Kulicheg/BomgeMoon/Images/BomgeMoon r1.jpg

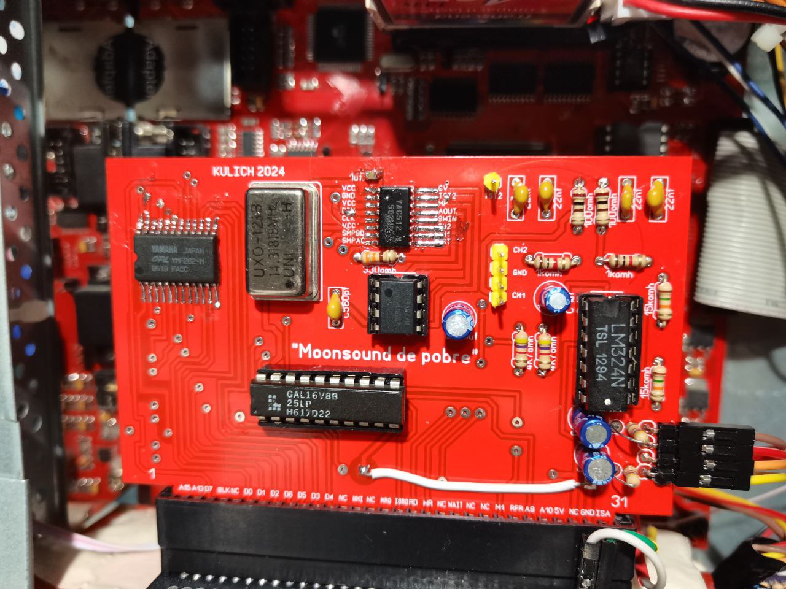
Images/BomgeMoon r1.jpg
