Kulicheg/BomgeMoon/README.md

# BomgeMoon
OPL3 sound card for ZX Spectrum

 Рекомендации:
 R8, R9 рекомендается  устанавливать меньшего номинала, вместо 15кОм следует устанавливать от 4.7 кОм. Для уменьшения искажений звука и уменьшения общей громкости карты.
 Резисторы на выходе карты  тогда можно заменить перемычками. Иначе для выравнивани громкости  можно установить резистор ~10 kOm

Revision 3  
- Edge коннектор сделан шире.  
- Увеличены отверстия под 3.5 джек.
- Исправлен шелк.

Внимание! Ревизия 01 содержит критические ошибки!
1) На лицевой стороне у Edge коннектора не убрана металицация и маска
2) У тестовых  площадок TST2 и CH2-GND-GND-CH1 нулевой отступ от полигонов что привело к КЗ между CH2-GND и TST2-GND (КЗ в переходном отверстии)
3) КЗ между 5в и 12в у разъема
4) КЗ между 5в и А11




**BOM**  
- DD1    YMF262-M    SOJ-24 
- DD2    GAL16V8     DIP-20
- DD3    YAC512      SOJ-16
- DD4    RC4558      DIP-8
- DD5    LM324       DIP-14 
- Q1     ген. 14,318 FULL
- C1     560pF  
- C2-C5  22nF  
- C6-C8  100 uF     5х7мм
- C9      1 uF      5х7мм
- C10-C14 1uF       0805  
- R1      330 Omh  
- R2, R3  4,7 kOmh  
- R4, R5  100 Omh  
- R6, R7  1 kOmph  
- R8, R9  15 kOmph
