Kulicheg/BomgeMoon/Schematic/MSX/opl3.pdf

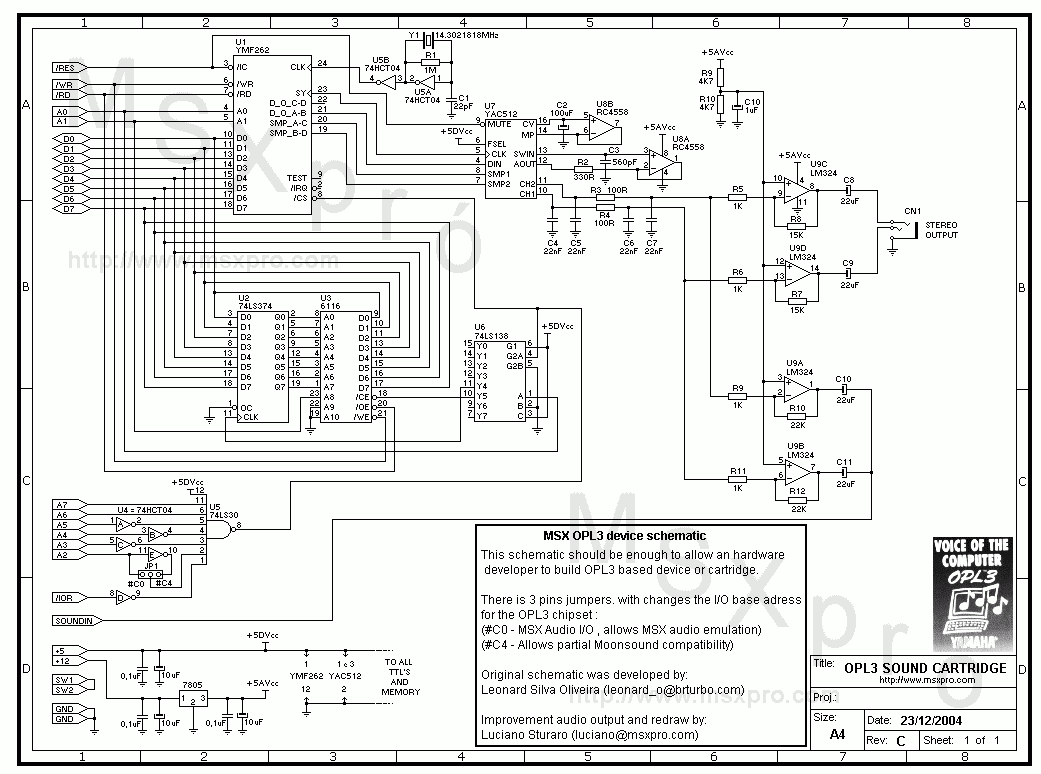
[picture p2: page 1]
