Kulicheg/BomgeMoon/PCB/PCB01_Rev2.PNG

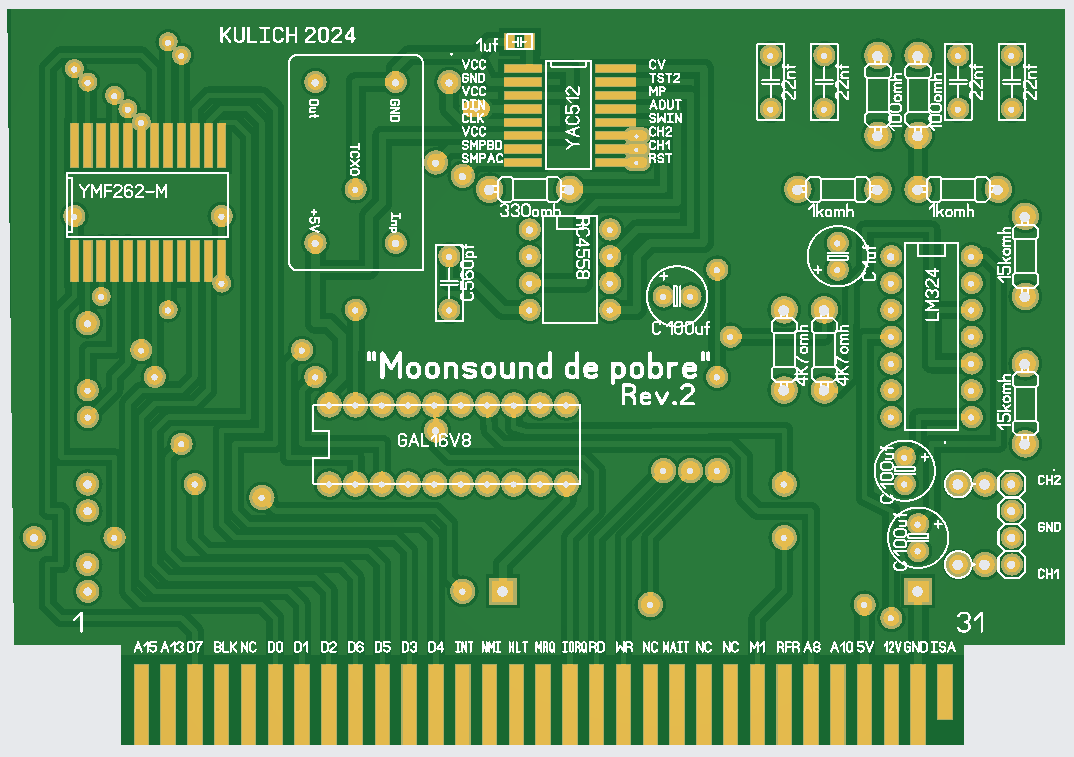
PCB/PCB01_Rev2.PNG
