Kulicheg/BomgeMoon/PCB/PCB02_Rev2.PNG

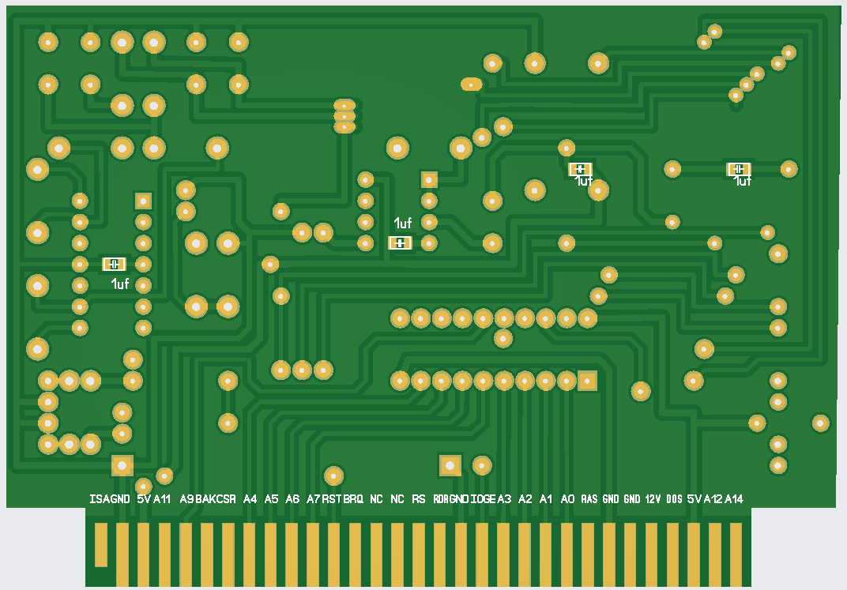
PCB/PCB02_Rev2.PNG
