Kulicheg/BomgeMoon/Schematic/ZX/BomgeMoon.pdf

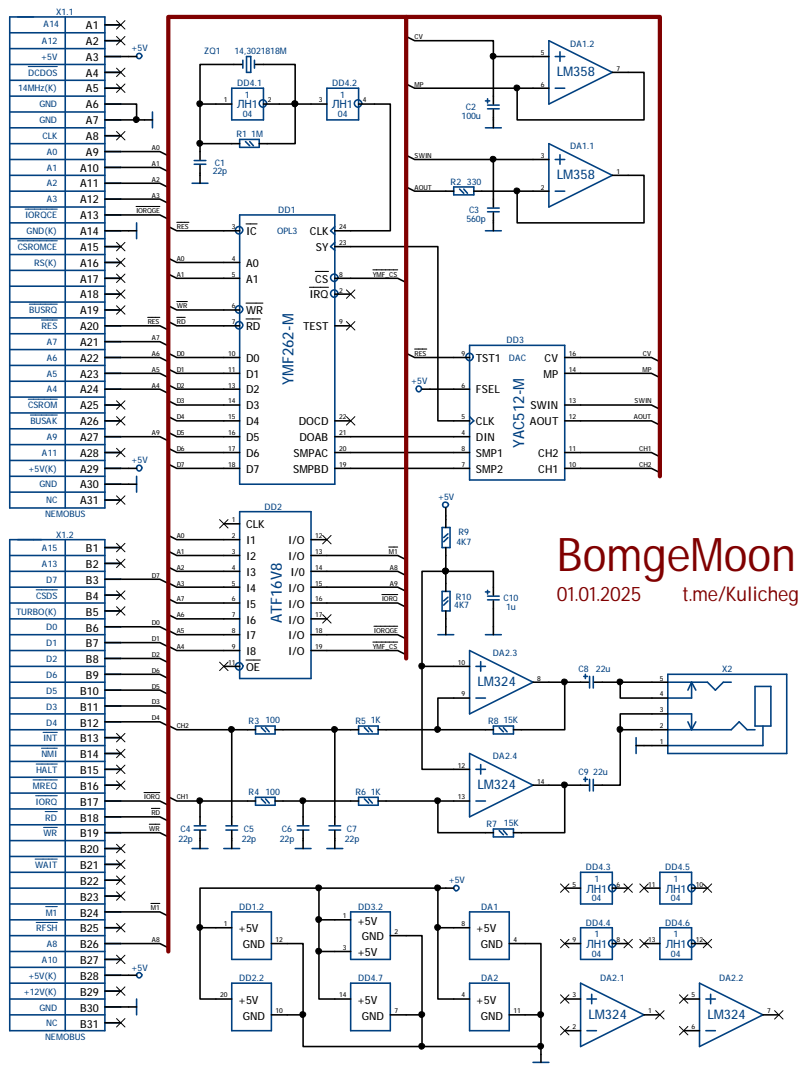
[picture p5: page 1]

A14 | A1
A12 | A2
+5V | A3
DCDOS | A4
14MHz(K) | A5
GND | A6
GND | A7
CLK | A8
A0 | A9
A1 | A10
A2 | A11
A3 | A12
IORQCE | A13
GND(K) | A14
CSROMCE | A15
RS(K) | A16

A17
A18

BUSRQ | A19
RES | A20
A7 | A21

A5 | A23
A4 | A24
CSROM | A25
BUSAK | A26
A9 | A27
A11 | A28
+5V(K) | A29
GND | A30
NC | A31

D7 | B3
CSDS | B4
TURBO(K) | B5
D0 | B6
D1 | B7
D2 | B8

D5 | B10 | R3 100
D3 | B11
D4 | B12
INT | B13
NMI | B14
HALT | B15
MREQ | B16
IORQ | B17
RD | B18
WR | B19
B20

WAIT | B21

A8 | B26
A10 | B27
+5V(K) | B28
