Kulicheg/BomgeMoon/(list of files, drawings)

Other design files:
PCB/Bomgemoon_Rev2.lay6
PCB/Bomgemoon_Rev3.lay6
PCB/EmuGena.lay6
