Kulicheg/BomgeMoon/(commit log)

2024-12-23 Bomgemoon r1
    [Bomgemoon.lay6, EmuGena.lay6]
2024-12-24 Added pcb visualisation
    [Bomgemoon_Rev2.lay6]
